ArshamFN/WaveShare-Jetson-ROS2-Rover/README.md

# Autonomous Rover - Jetson + ROS2 Navigation

A 4WD autonomous ground robot built on the Waveshare UGV02 platform with an NVIDIA Jetson Orin Nano Super, running ROS2 Humble with live SLAM, Nav2 autonomous navigation, and autonomous mapping with a custom frontier explorer.





## Project Overview

**Goal:** Build a production-ready autonomous navigation system from scratch to demonstrate ROS2 development skills.

**Why This Project:**
- Master ROS2 architecture (nodes, topics, services, actions)
- Implement SLAM-based mapping and localization
- Deploy autonomous waypoint navigation with Nav2
- Document real engineering problem-solving
- Build an AI-ready platform for future computer vision integration

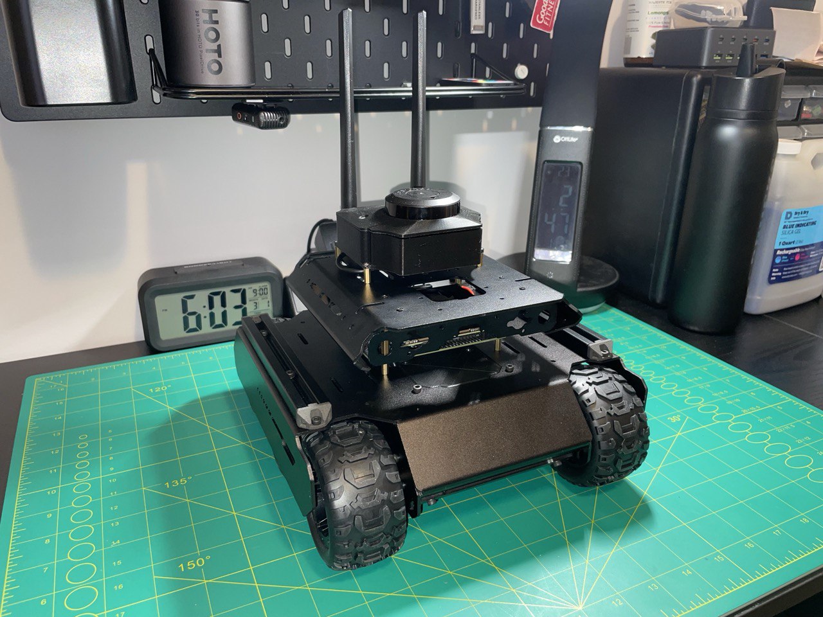
[picture p1: images/testing/session-006-migration/session-006-UGV02-front.jpg]
UGV02 fully assembled with migrated hardware


## Hardware Platform

### Core Components
- **Platform:** Waveshare UGV02 (4WD skid-steer chassis)
- **Compute:** NVIDIA Jetson Orin Nano Super Developer Kit (8GB RAM, 67 TOPS AI)
- **Sensors:** Slamtec RPLidar C1 (12m range, 10Hz, TOF technology)
- **Power:** 3× 18650 cells in series via WaveShare UPS Module 3S
- **Motor Control:** Multi-Functional Driver (MFD) board over USB serial (`/dev/rover`), running closed-loop wheel speed control

### Technical Specifications

| Component | Specification |
|---|---|
| **Drivetrain** | 4× DCGM-370-12V-EN-333RPM motors, skid-steer kinematics |
| **Encoder Resolution** | ~20 PPR (front wheels only; rear wheels unencoded) |
| **Motor Stall Torque** | ~5.0 kg·cm |
| **CPU** | 6-core ARM Cortex-A78AE @ 1.7GHz |
| **GPU** | 512 CUDA cores + Tensor cores (67 TOPS) |
| **RAM** | 8GB LPDDR5 |
| **LiDAR Range** | 12m max (white objects); 6m (black objects) |
| **LiDAR Scan Rate** | 5kHz sample rate @ 10Hz rotation |
| **LiDAR Angular Resolution** | 0.72° typical |
| **Light Resistance** | 40,000 lux |
| **Battery Pack** | 3S 18650, 11.1V nominal, 12.6V full charge |

### Power Architecture

| Component | Power Source |
|---|---|
| Jetson Orin Nano Super | BAT rail (9 to 12.6V) via 5.5mm barrel jack |
| MFD Board | BAT rail (9 to 12.6V) direct |
| RPLidar C1 | Jetson Orin Nano Super USB port |

### Runtime Estimates (25W Jetson mode, 25% real-world derating applied)

| Motor Load | Estimated Runtime |
|---|---|
| Cruising | ~47 min |
| Under load | ~35 min |

25W mode is the operational standard for SLAM sessions. It balances compute performance
with sufficient runtime for a full mapping run.

## Software Stack

- **Operating System:** Ubuntu 22.04 LTS (JetPack 6.2.1)
- **ROS Distribution:** ROS2 Humble Hawksbill
- **Navigation Framework:** Nav2 with the Regulated Pure Pursuit controller
- **Exploration:** `rover_explorer`, a custom frontier explorer; m-explore-ros2's `explore_lite` is kept as a baseline
- **SLAM Algorithm:** slam_toolbox (synchronous mapping mode, CeresSolver)
- **Odometry:** rf2o_laser_odometry (Range Flow-based 2D Odometry from laser scans)
- **Visualization:** RViz2
- **Remote Operation:** Foxglove desktop on a handheld ASUS ROG Ally, through `foxglove_bridge`
- **Development Languages:** Python 3.10, C++17

## Current Status

**Last Updated:** October 13, 2026

The rover navigates autonomously. Nav2 plans and follows paths on a map that
slam_toolbox builds live, and the rover drives to goal poses set in RViz, including
through narrow gaps. Pose estimation comes from the LiDAR: `rf2o_laser_odometry`
computes planar odometry from consecutive laser scans and owns the `odom → base_link`
transform. It replaced gyrodometry as the primary odometry source because gyroscope
calibration depends on both driving surface and operating temperature, while the LiDAR
is unaffected by either.

The `rover_driver` node converts velocity commands into wheel speed targets in m/s for
the MFD board's closed-loop speed controller, and lifts small non-zero commands to a
0.10 m/s floor that the controller can regulate. It also applies a velocity ramp, a
command watchdog, and Zero Velocity Update (ZUPT), and publishes wheel odometry on
`/odom_wheel`, raw gyroscope data on `/imu/gz`, and battery voltage on
`/battery_voltage`. Its heading hold controller is implemented but disabled, because
Nav2 runs its own closed loop.

The rover is operated from a handheld pendant: Foxglove desktop on an ASUS ROG Ally,
connected to `foxglove_bridge` on the Jetson. It shows the live map, laser scan, robot
pose, costmaps, and Nav2's planned path; sends Nav2 goals; drives the rover with the
Ally's sticks behind a deadman button; starts and stops the stack; saves maps; and shuts
the Jetson down. The Jetson joins home Wi-Fi when it is in range and otherwise hosts its
own network, so the pendant needs no router.

The rover also maps the house on its own. Once exploration is started, `rover_explorer`
chooses where to go next from the live map and sends Nav2 goals until no reachable
frontier is left, finishing one area before moving to the next. The autosave node then
drives the rover back to its start pose and saves the final map into `maps/`, keeping
map checkpoints, slam_toolbox pose graphs, and an event and battery log for every run.
`rover_explorer` replaced `explore_lite` after an offline simulator, run on real maps of
the house with the explorer's own planning code, showed it driving 19 to 28% less from
the same start poses.

The handheld control unit driving the rover while Nav2 navigates the house (https://www.youtube.com/watch?v=RMOsRye9tLc)

*[Watch on YouTube](https://www.youtube.com/watch?v=RMOsRye9tLc): the handheld control unit driving the rover while Nav2 navigates the house.*

### Completed Milestones

**Hardware:**
- ✅ Full mechanical assembly with custom 3D-printed MFD cover and RPLidar mount
- ✅ Power architecture designed and validated, with both boards on the BAT rail
- ✅ Persistent USB device symlinks: `/dev/lidar` (RPLidar C1), `/dev/rover` (MFD board)
- ✅ Platform migration from Wave Rover to UGV02 (motivated by encoder availability)

**Software:**
- ✅ JetPack 6.2.1 flashed and configured
- ✅ ROS2 Humble installed and verified
- ✅ Remote access via PuTTY (SSH) and NoMachine (desktop)
- ✅ RPLidar C1 driver built from source, with a live `/scan` topic confirmed
- ✅ `rover_driver` ROS2 node: full `/cmd_vel` to MFD JSON bridge operational
- ✅ `robot_description` package: URDF with a measured `base_link → laser` transform (0.1685 m height, 180° yaw)
- ✅ SLAM Toolbox configured in synchronous mapping mode with CeresSolver
- ✅ Gyrodometry implemented: gyroscope (`gz`) for heading, encoder average `(odl + odr) / 2` for linear displacement
- ✅ First coherent SLAM map produced with gyrodometry active
- ✅ Software velocity ramp on both axes: linear (0.8 m/s²) and angular (2.0 rad/s²)
- ✅ Forward-only heading hold PD controller: gyro-based straight-line correction with settle gate, deadband, spike clamp, and output cap
- ✅ Zero Velocity Update (ZUPT): continuous gyro bias correction during stationary pauses
- ✅ SLAM Toolbox parameters tuned: 1 s map updates, full 10 Hz scan ingestion, and a 15 m loop closure search radius
- ✅ `rf2o_laser_odometry` built from source and integrated, publishing `/odom` at 10 Hz
- ✅ Odometry architecture migrated to LiDAR-primary: RF2O owns `odom → base_link`, and wheel odometry is retained on `/odom_wheel` for comparison
- ✅ First geometrically accurate room map, with single-cell walls and every room feature correctly placed
- ✅ LiDAR orientation corrected in the URDF: the RPLidar C1's zero-bearing beam faces the rear of the rover
- ✅ Motor constants measured: `MAX_WHEEL_SPEED = 0.956 m/s` (LiDAR wall ranging), `TRACK_WIDTH = 0.174 m` (caliper), acceleration 0.648 m/s², deceleration 0.699 m/s²
- ✅ Nav2 integrated with Regulated Pure Pursuit: autonomous navigation to goal poses, including through narrow gaps
- ✅ `/cmd_vel` watchdog: the driver zeroes the wheel command if commands stop arriving for 0.5 s; the check runs on each feedback packet from the MFD board, so it depends on that feedback
- ✅ Battery monitoring on `/battery_voltage`, with warnings at 10.5 V and 9.6 V
- ✅ RF2O startup race fixed: the laser pose lookup now retries until the transform exists (patched fork)
- ✅ Wheel commands sent in m/s to the MFD's closed-loop speed controller, with a 0.10 m/s floor that makes low-speed motion and in-place rotation reliable on every surface tested
- ✅ Repository builds from a fresh clone, with third-party packages pinned in `rover.repos`
- ✅ Desktop launchers for bringup, teleop, and Nav2
- ✅ Handheld pendant: Foxglove desktop on an ASUS ROG Ally, connected to the Jetson through `foxglove_bridge`
- ✅ `twist_mux` velocity chain: stick teleop with a deadman overrides Nav2, with teleop-mode and e-stop locks
- ✅ systemd services for the bridge, pendant control, bringup, and Nav2, with a zero wheel command after every bringup stop
- ✅ Pendant control node: one-button start and stop, map saving by name, and a two-press safe shutdown
- ✅ Router-free operation: the Jetson hosts its own Wi-Fi network when home Wi-Fi is out of range
- ✅ ROS 2 discovery restricted to localhost, so a Wi-Fi change cannot split the ROS graph
- ✅ tf2 deadlock that froze Nav2 fixed by upgrading geometry2 to 0.25.24
- ✅ Autonomous mapping: `rover_explorer` explores the whole house without an operator and stops when no reachable frontier is left
- ✅ Frontier planner based on driving distance, reachability for the rover's footprint, viewpoints that see the frontier, commitment to the current target, and a route through the frontiers
- ✅ Map autosave: checkpoints every 5 minutes, return to the start pose, then the final map save, with per-run event, battery, and Nav2 logs
- ✅ Offline exploration simulator on real maps of the house, running the robot's own planner code
- ✅ systemd service for exploration that runs only while bringup and Nav2 are running

### Known Hardware Notes

- **MFD encoder wiring swap:** The `odl`/`odr` odometry fields in the MFD's T:1001 feedback
  packet are physically reversed, so left and right encoder readings are swapped on the
  board. All odometry code accounts for this swap.
- **Front-wheel-only encoding:** Only the front axle motors carry encoders. Rear wheels are
  passive and unencoded. Odometry is computed from front wheel data only.
- **Speed control floor:** The MFD's closed-loop wheel speed control cannot regulate
  targets below about 0.08 m/s, the limit of its 20 PPR encoders. `rover_driver` lifts
  any non-zero command below that to 0.10 m/s.
- **Skid-steer scrub:** In-place rotation achieves about 43% of the rate predicted from
  wheel speeds, consistently across surfaces, which corresponds to an effective track
  width of about 0.405 m. Nav2's closed loop absorbs the difference.
- **LiDAR zero bearing faces rearward:** With the RPLidar C1 mounted as documented, its
  zero-bearing beam points to the rear of the rover. The URDF laser joint carries a 180°
  yaw to match.
- **Battery sag under hard acceleration:** Commanding all four motors from a standstill at
  full speed causes a simultaneous peak current draw that can sag the battery below the
  Jetson's minimum operating voltage, triggering a protective shutdown. A software velocity
  ramp in `rover_driver` limits acceleration to 0.8 m/s² and eliminates the shutdown under
  normal operation.
- **ttyTHS1 UART bug:** The Jetson Orin Nano has a known data corruption bug on `/dev/ttyTHS1`
  requiring RTS/CTS hardware flow control. See the Session 002 log for the full fix.
  Rover communication uses the MFD's dedicated USB serial port (`/dev/rover`) for reliability.
- **UPS power rail routing:** The Jetson must be powered from the BAT rail via barrel jack,
  not the 5V regulated output. The 5V buck converter cannot handle the combined load of
  the MFD board and Jetson simultaneously.

## Getting Started

### Requirements

- Jetson running Ubuntu 22.04 (JetPack 6.2.1) with ROS2 Humble
- The ROS packages and tools the stack uses:

```bash
sudo apt install ros-humble-slam-toolbox ros-humble-navigation2 ros-humble-nav2-bringup \
  ros-humble-teleop-twist-keyboard python3-vcstool python3-serial \
  ros-humble-foxglove-bridge ros-humble-twist-mux ros-humble-teleop-twist-joy iw \
  python3-scipy
```

- tf2 (geometry2) 0.25.24 or newer: 0.25.23 can deadlock Nav2 inside tf2's `Buffer`
  (see the Session 016 log)

- The `/dev/rover` udev symlink for the MFD board (see [`src/rover_driver/README.md`](src/rover_driver/README.md))

### Build

The repository is a complete colcon workspace. The launchers and the Nav2 command below
assume it lives at `~/ros2_ws`.

```bash
git clone https://github.com/ArshamFN/WaveShare-Jetson-ROS2-Rover.git ~/ros2_ws
cd ~/ros2_ws
vcs import src < rover.repos
source /opt/ros/humble/setup.bash
colcon build --symlink-install
source install/setup.bash
```

`vcs import` pulls the three third-party packages at the exact commits pinned in
`rover.repos`: a patched fork of `rf2o_laser_odometry`, Slamtec's `rplidar_ros`, and
m-explore-ros2, whose `explore_lite` is kept as an exploration baseline.

All ROS 2 nodes run on the Jetson, so ROS 2 discovery is restricted to localhost, which
keeps a Wi-Fi change from splitting the ROS graph. The services and desktop launchers set
this themselves; for terminals, add it to `~/.bashrc` after the ROS setup lines:

```bash
echo 'export ROS_LOCALHOST_ONLY=1' >> ~/.bashrc
```

ROS 2 tools, including RViz, run on the Jetson itself, for example through NoMachine.

### Run

Bring up the driver, velocity mux, joystick teleop, LiDAR, RF2O, and slam_toolbox in one command:

```bash
ros2 launch robot_description bringup.launch.py
```

Add `use_rviz:=true` to open RViz on the Jetson. Then, in separate terminals, drive
with the keyboard:

```bash
ros2 run teleop_twist_keyboard teleop_twist_keyboard
```

or start Nav2 and send goals from RViz with the Nav2 Goal tool (Fixed Frame `map`):

```bash
ros2 launch nav2_bringup navigation_launch.py use_sim_time:=false \
  params_file:=$HOME/ros2_ws/src/robot_description/config/nav2_params.yaml
```

`teleop_twist_keyboard` publishes on `/cmd_vel`, which `twist_mux` in bringup treats as
the navigation input, so either pendant lock blocks it. With the services from
[Handheld Pendant](#handheld-pendant) installed, the pendant can also start and stop
bringup and Nav2. Start them from one place at a time: the pendant refuses to start
either while a copy started elsewhere is running.

### Autonomous Exploration

With bringup, Nav2, and the pendant control node running (the autosave node saves maps
through `/pendant/save_map`), start exploration through its service:

```bash
systemctl --user start rover-explore
journalctl --user -u rover-explore -f -o cat
```

or directly:

```bash
ros2 launch rover_explore explore.launch.py
```

Add `explorer:=explore_lite` to run the baseline instead. The rover explores until no
reachable frontier is left, drives back to its start pose, and saves the final map as
`maps/explore_<YYYYMMDD-HHMMSS>_final.pgm` and `.yaml`. Checkpoints, pose graphs, and
the run's `events.csv` and `battery.csv` go to `~/rover_runs/explore_<YYYYMMDD-HHMMSS>/`.
`systemctl --user stop rover-explore` pauses exploration, which cancels the current goal
or the drive home, and then stops both nodes. A run stopped before exploration completes
keeps its checkpoints and the live SLAM map, but saves no final map.

### Desktop Launchers

`tools/launchers/` holds one-click desktop launchers for bringup, teleop, and Nav2. To
install them:

```bash
mkdir -p ~/bin
for s in bringup_rover teleop_rover nav2_rover; do ln -sf ~/ros2_ws/tools/launchers/$s.sh ~/bin/$s.sh; done
cp ~/ros2_ws/tools/launchers/*.desktop ~/Desktop/
for d in ~/Desktop/Rover*.desktop; do chmod +x "$d"; gio set "$d" metadata::trusted true; done
```

The `.desktop` files point at `/home/arshamfn/bin`; adjust their `Exec` lines for a
different user.

### Handheld Pendant

The pendant is Foxglove desktop on an ASUS ROG Ally running Windows 11; nothing
ROS-related runs on the Ally. Foxglove connects to `foxglove_bridge` over a WebSocket on
port 8765, at the Jetson's address on the home network or at `ws://10.42.0.1:8765` on
the rover's own network. The layout shows the live map, laser scan, robot pose,
costmaps, and Nav2's planned path; sends Nav2 goals; drives the rover with the Ally's
sticks behind a deadman button; starts and stops the stack; saves maps; and shuts the
Jetson down.

**Velocity chain.** `twist_mux` merges the velocity sources into `/cmd_vel_mux`, the
only velocity input of `rover_driver`. Nav2 is unchanged.

| Input or lock | Topic | Priority | Timeout |
|---|---|---|---|
| Navigation (Nav2, keyboard teleop) | `/cmd_vel` | 10 | 0.5 s |
| Joystick | `/cmd_vel_joy` | 100 | 0.5 s |
| Teleop-mode lock | `/pendant/teleop_mode` (`std_msgs/Bool`) | 50 | none |
| E-stop lock | `/pendant/estop` (`std_msgs/Bool`) | 255 | none |

While LB (button 4) is held, `teleop_twist_joy` turns the pendant's `/joy` into
`/cmd_vel_joy`, up to 0.25 m/s and 1.5 rad/s. Releasing LB stops the rover, and Nav2
resumes once the joystick input times out. The locks do not time out and the e-stop lock
travels over Wi-Fi, so the chassis power switch remains the emergency stop.

**Services.**

| Service | Starts | Runs |
|---|---|---|
| `rover-bridge` | at boot | `foxglove_bridge` |
| `rover-control` | at boot | the `pendant_bridge` control node |
| `rover-bringup` | on demand | `bringup.launch.py` without RViz, then `rover_zero_motors.py` after every stop or crash, because the MFD board keeps executing its last command |
| `rover-nav2` | on demand | Nav2, stopping whenever bringup stops |
| `rover-explore` | on demand | `explore.launch.py`; refuses to start unless bringup and Nav2 are running, stops with either, and pauses exploration before it stops |

**Pendant interface.**

| Name | Type | Purpose |
|---|---|---|
| `/pendant/toggle_bringup` | `Trigger` | Starts bringup if stopped and stops it if running; refuses while it is starting or stopping, and presses less than 2 s apart |
| `/pendant/toggle_nav2` | `Trigger` | The same for Nav2; starts it only while bringup runs |
| `/pendant/set_bringup`, `/pendant/set_nav2` | `SetBool` | Explicit start and stop |
| `/pendant/save_map` | `SaveMap` | Saves `maps/<name>.pgm` and `.yaml`; letters, digits, `_` and `-` only; never overwrites |
| `/pendant/shutdown` | `Trigger` | Two presses within 5 s stop Nav2, then bringup, then power the Jetson off |
| `/pendant/bringup_active`, `/pendant/nav2_active` | `Bool` | State, 1 Hz |
| `/pendant/control_result` | `String` | One line per command outcome |

**Network.** The onboard Wi-Fi card cannot host a network and join one at the same time.
At boot the Jetson joins home Wi-Fi if it is in range; otherwise NetworkManager starts
the rover's own network, `NullIsland-Rover` (2.4 GHz, channel 6, WPA2, Jetson at
`10.42.0.1`). While running, the `rover-net-watchdog` system service checks every 15 s:
with no Wi-Fi connection for 60 s it starts the rover's network; while a client is
connected to the rover's network it takes no action; after 5 minutes with no client it
tries home Wi-Fi for up to 40 s and restores the rover's network if home Wi-Fi is not
there. A reading that fails or hangs never causes a change.

**Setup on the Jetson:**

1. User services, with lingering so they start at boot without a login:

   ```bash
   cd ~/ros2_ws && ./tools/systemd/install.sh
   sudo loginctl enable-linger "$(whoami)"
   ```

2. Permission for the pendant to power off the Jetson, validated before it is
   installed:

   ```bash
   echo "$(whoami) ALL=(root) NOPASSWD: /usr/bin/systemctl poweroff" > ~/rover-poweroff.sudoers
   sudo visudo -cf ~/rover-poweroff.sudoers
   sudo install -m 0440 -o root -g root ~/rover-poweroff.sudoers /etc/sudoers.d/rover-poweroff
   rm ~/rover-poweroff.sudoers
   ```

3. The rover's network, with the password typed rather than saved in shell history, and
   the home network ranked above it:

   ```bash
   nmcli con add type wifi ifname wlP1p1s0 con-name rover-ap ssid NullIsland-Rover \
     802-11-wireless.mode ap 802-11-wireless.band bg 802-11-wireless.channel 6 \
     ipv4.method shared ipv4.addresses 10.42.0.1/24 ipv6.method disabled \
     wifi-sec.key-mgmt wpa-psk wifi-sec.proto rsn wifi-sec.pairwise ccmp wifi-sec.group ccmp \
     connection.autoconnect no connection.autoconnect-priority -100
   read -rs P && nmcli con modify rover-ap wifi-sec.psk "$P" && unset P
   nmcli con modify rover-ap connection.autoconnect yes
   nmcli con modify "<home network>" connection.autoconnect-priority 10
   ```

4. The network watchdog. Its settings file holds the home Wi-Fi's name, so it lives
   outside the repository, in `/etc/rover-net-watchdog.conf`. The first command installs
   the template only if that file does not exist yet; in the editor, replace
   `[Home Wi-Fi name here]` with the NetworkManager name of the home Wi-Fi
   (`nmcli -t -f NAME,TYPE connection show` lists them):

   ```bash
   [ -e /etc/rover-net-watchdog.conf ] || sudo install -m 0600 -o root -g root tools/network/rover-net-watchdog.conf /etc/rover-net-watchdog.conf
   sudoedit /etc/rover-net-watchdog.conf
   sudo install -m 0755 -o root -g root tools/network/rover-net-watchdog.sh /usr/local/sbin/rover-net-watchdog
   sudo install -m 0644 -o root -g root tools/network/rover-net-watchdog.service /etc/systemd/system/rover-net-watchdog.service
   sudo systemctl daemon-reload
   sudo systemctl enable rover-net-watchdog
   sudo systemctl restart rover-net-watchdog
   ```

   If the settings file is missing or still holds the placeholder, the watchdog logs the
   reason and exits without changing the network. NetworkManager's boot fallback works
   without it.

5. The `ROS_LOCALHOST_ONLY` line from [Build](#build).

**Setup on the Ally.** Install Foxglove desktop and sign in once while online; it runs
offline afterwards. Install the Joystick panel extension (`joshnewans/foxglove-joystick`)
and set the Ally's control mode to Gamepad. The layout uses:

- a 3D panel with display frame `map` showing `/map`, `/scan`, the costmaps and `/plan`,
  with its pose publish tool on `/goal_pose`;
- a Joystick panel in Gamepad mode with Publish Mode on, publishing `/joy`;
- Service Call panels for `/pendant/toggle_bringup`, `/pendant/toggle_nav2` and
  `/pendant/shutdown` (request `{}`) and for `/pendant/save_map` (request
  `{"name": {"data": "<name>"}}`);
- Indicator panels on `/pendant/bringup_active.data` and `/pendant/nav2_active.data`;
- a gauge on `/battery_voltage.data`;
- a Raw Message panel on `/pendant/control_result.data`.

### Repository Layout

```
.gitignore  LICENSE  README.md  rover.repos
cad/                       CAD files for the custom covers and mounts
docs/                      bill of materials, software notes, and session logs
images/                    build and test photos
maps/                      saved slam_toolbox maps
scripts/                   calibration and test scripts
tools/launchers/           desktop launchers for bringup, teleop, and Nav2
tools/systemd/             systemd user services for the pendant, the stack, and exploration
tools/network/             network watchdog: home Wi-Fi or the rover's own network
tools/explore_sim/         offline exploration simulator
src/rover_driver/          /cmd_vel to MFD bridge
src/robot_description/     URDF, launch files, and parameters
src/pendant_bridge/        pendant control node
src/rover_explore/         frontier explorer and map autosave node
src/rf2o_laser_odometry/   not tracked; pulled via rover.repos
src/rplidar_ros/           not tracked; pulled via rover.repos
src/m-explore-ros2/        not tracked; pulled via rover.repos
```

## ROS2 Packages

### rover_driver
A ROS2 Python node that bridges the standard `/cmd_vel` topic to the UGV02 MFD board's
JSON-over-serial protocol. It converts each `geometry_msgs/Twist` into left and right
wheel speed targets in m/s, which the board's closed-loop controller holds. Non-zero
targets below the controller's regulation floor are scaled up together to 0.10 m/s,
preserving the commanded turn curvature. The node also applies a velocity ramp on both
axes, zeroes the wheel command if `/cmd_vel` goes stale for 0.5 s (checked on each
feedback packet from the board, so the check depends on that feedback), and runs ZUPT
for continuous gyro bias correction. It publishes wheel-derived odometry to
`/odom_wheel`, raw gyroscope data to `/imu/gz`, and battery voltage to
`/battery_voltage`. It does not
broadcast `odom → base_link`; that transform is owned by `rf2o_laser_odometry`. A
forward-only heading hold PD controller is implemented but disabled by default, because
Nav2 runs its own closed loop.

```bash
ros2 run rover_driver rover_driver_node
```

See [`src/rover_driver/README.md`](src/rover_driver/README.md) for full setup instructions.

### robot_description
A ROS2 package containing the rover's URDF, launch files, and parameters. The URDF
defines the `base_link → laser` transform at 0.1685 m height with a 180° yaw, derived
from physical measurement. `bringup.launch.py` starts `robot_state_publisher`,
`rover_driver`, `twist_mux`, `teleop_twist_joy`, the LiDAR driver, RF2O (after 3 s), and
slam_toolbox (after 5 s), with optional RViz. `rover_driver`'s velocity input is
remapped to `/cmd_vel_mux`. The `config/` directory holds the slam_toolbox, RF2O, and
Nav2 parameters, and the `twist_mux` and joystick teleop parameters. slam_toolbox is
tuned for 1 s map updates, full 10 Hz scan ingestion, and a 15 m loop closure search
radius suited to indoor mapping.

```bash
ros2 launch robot_description bringup.launch.py
```

### pendant_bridge
A ROS2 Python node, `pendant_control`, that lets the handheld pendant run the rover. It
starts and stops the bringup and Nav2 services through `systemctl --user`, publishes
their state, saves the live map with `nav2_map_server`'s `map_saver_cli`, and runs the
two-press shutdown. It refuses to start bringup or Nav2 while a copy started outside
systemd is running, and it powers the Jetson off only when its `allow_poweroff`
parameter is true, which only the installed service sets.

```bash
ros2 run pendant_bridge control_node
```

### rover_explore
Autonomous mapping: the `rover_explorer` frontier explorer, the `explore_autosave` node,
and `explore.launch.py`, which starts the autosave node and, 3 s later, the explorer.

`rover_explorer` keeps every exploration decision in `frontier_planner.py`, which uses
only numpy and scipy, so the offline simulator in `tools/explore_sim/` runs the same code.
Every 2 s, and after each Nav2 goal ends, it finds the frontiers between known free and
unknown space on `/map`, the cells the rover's footprint can reach, and for each frontier
a viewpoint that sees a useful part of it, preferring viewpoints with 0.25 m of
clearance. It ranks the frontiers by driving distance to their viewpoints plus a turn
cost, orders the 20 cheapest into a route by the driving distances between viewpoints,
keeps its current target unless the route is shorter without it, and sends one
`navigate_to_pose` goal at a time, re-sending it only when the viewpoint moves 0.5 m or
more. A frontier that teaches the map nothing is retried from a viewpoint at
least 1 m away and excluded after two such viewpoints, or after a repeated Nav2 failure.
Exploration is complete after two decisions in a row, each on a newer map, find no
reachable frontier. The node publishes the same `/explore/status` messages as
`explore_lite`, obeys `/explore/resume`, and draws the frontiers, its target, and
excluded frontiers on `/explore/frontiers`.

`explore_autosave` saves a map checkpoint every 5 minutes while exploration runs and
serializes the slam_toolbox pose graph with every save. When exploration completes it
drives the rover back to the pose it had at startup, then saves the final map into
`maps/`. It logs events and battery voltage to CSV files in the run folder, together with
Nav2's goal, failure, and recovery counts and the distance driven from `/odom`. It never
publishes velocity commands.

All parameters are in `config/explore_params.yaml`.

```bash
ros2 launch rover_explore explore.launch.py
```

### rf2o_laser_odometry
Range Flow-based 2D Odometry: estimates planar motion directly from consecutive
RPLidar scans and publishes `nav_msgs/Odometry` to `/odom` along with the
`odom → base_link` transform. Built from a fork of the Adlink-ROS ROS2 port, patched
so the node retries its `base_link → laser` lookup at startup instead of silently
falling back to an identity transform. Its parameters live in
`src/robot_description/config/rf2o_params.yaml`, including an empty
`init_pose_from_topic`: left at its default of `/base_pose_ground_truth`, a
simulation-only topic, the node waits indefinitely on real hardware.

See [`docs/software/rf2o-laser-odometry.md`](docs/software/rf2o-laser-odometry.md) for build notes.

### rplidar_ros
Slamtec's official ROS2 LiDAR driver, built from source to include RPLidar C1 support.

```bash
ros2 launch rplidar_ros rplidar_c1_launch.py
```

See [`docs/software/rplidar-ros.md`](docs/software/rplidar-ros.md) for full setup instructions.

## Documentation

- [Bill of Materials](docs/hardware/bill-of-materials.md): complete parts list with suppliers and costs
- [Test Logs & Build Journal](docs/testing/0000-test-logs.md): full session-by-session build history
- [RF2O Laser Odometry notes](docs/software/rf2o-laser-odometry.md)
- [RPLidar ROS2 driver notes](docs/software/rplidar-ros.md)
- [Exploration simulator](tools/explore_sim/README.md)

## Author

**Arsham Faghihnasiri**

Building autonomous systems and learning production ROS2 development.

- 📍 Greater Toronto Area, Ontario, Canada
- 💼 [LinkedIn](https://www.linkedin.com/in/arsham-faghihnasiri)
- 📧 arshamfaghihnasiri@gmail.com
- 🎓 Software Engineering

## Acknowledgments

- Waveshare for the UGV02 platform and MFD board
- NVIDIA for Jetson developer tools and documentation
- Slamtec for the RPLidar SDK and ROS2 driver
- MAPIRlab for rf2o_laser_odometry, and Adlink-ROS for its ROS2 port
- Jiří Hörner for explore_lite, and robo-friends for its ROS2 port, m-explore-ros2
- The ROS2 and Nav2 open source communities

## License

MIT License. See [LICENSE](LICENSE) for details.
