ArshamFN/WaveShare-Jetson-ROS2-Rover/cad/rover-top-face-reference/WaveShare-Wave-Rover-Top-Face-Reference-README.md

# Rover Top Face Reference
   3D model of the rover's top face, used as a reference for designing the Jetson mount.
