ArshamFN/WaveShare-Jetson-ROS2-Rover/cad/rover-top-face-reference/WaveShare-Wave-Rover-Top-Face-Reference.png

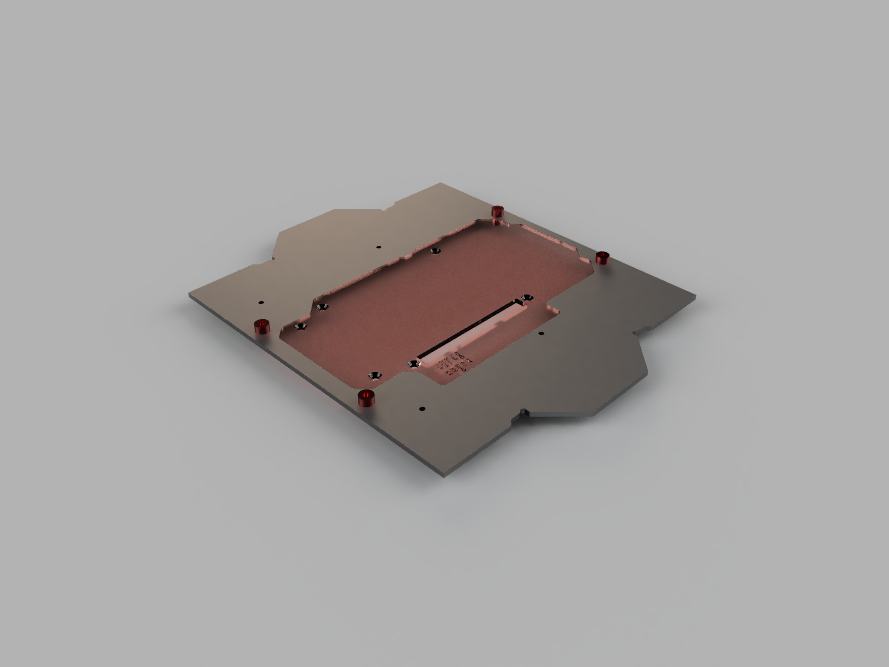
cad/rover-top-face-reference/WaveShare-Wave-Rover-Top-Face-Reference.png
