ArshamFN/WaveShare-Jetson-ROS2-Rover/docs/hardware/bill-of-materials.md

# Bill of Materials

**Last Updated:** Feb 22, 2026
**Total Cost:** ~$807 CAD (after tax)

---

## Core Platform

| Item | Model | Qty | Unit Price | Total | Supplier | Status |
|---|---|-----|---|---|---|---|
| Robot Base | Waveshare Wave Rover | 1 | $136.55 | $136.55 | Amazon.ca | ✅ Received |
| Compute Board | NVIDIA Jetson Orin Nano Super Developer Kit (8GB) | 1 | $375.67 | $375.67 | Amazon.ca | ✅ Received |
| Lidar Sensor | Slamtec RPLidar C1 | 1 | $93.99 | $93.99 | Amazon.ca | ✅ Received |
| Batteries | 18650 Lithium (2200mAh+) | 4 | - | $65.98 | Amazon.ca | ✅ Received |

**Subtotal:** $672.19 CAD (before tax)
**Subtotal with tax:** $759.58 CAD

---

## Additional Hardware

| Item | Qty | Price (after tax) | Supplier | Status |
|---|-----|---|---|---|
| DisplayPort to HDMI Cable (6ft) | 1 | $12.42 | Amazon.ca | ✅ Received |
| M2.5 40+6mm Female-to-Male Brass Hex Standoff Spacers (20pcs) | 1 | $19.20 | Amazon.ca | ✅ Received |
| Dual Band WiFi Antenna Kit + MHF4 IPEX Pigtail Cables (M.2/NGFF, 2x5dBi) | 1 | $15.22 | Amazon.ca | ✅ Received |

**Subtotal:** $46.84 CAD (after tax)

---

## Accessories (Included with Wave Rover)

- ESP32 controller module
- UPS power management board
- 4x N20 motors with encoders
- 4x Wheels
- Metal chassis with mounting plates
- Servo expansion board

---

## TOTAL PROJECT COST: ~$806 CAD (after tax)

---

## Notes

- Batteries: 4x purchased, 3x used for rover (1x spare)
- Standoffs used for mounting Jetson Orin Nano Super to rover
- WiFi antenna required for reliable wireless connectivity on Jetson
- All core components confirmed compatible with ROS2 Humble
- Power system rated for ~2-3 hours runtime
```
