ArshamFN/WaveShare-Jetson-ROS2-Rover/cad/rover-top-face-reference/WaveShare-Wave-Rover-Top-Face-Reference.step

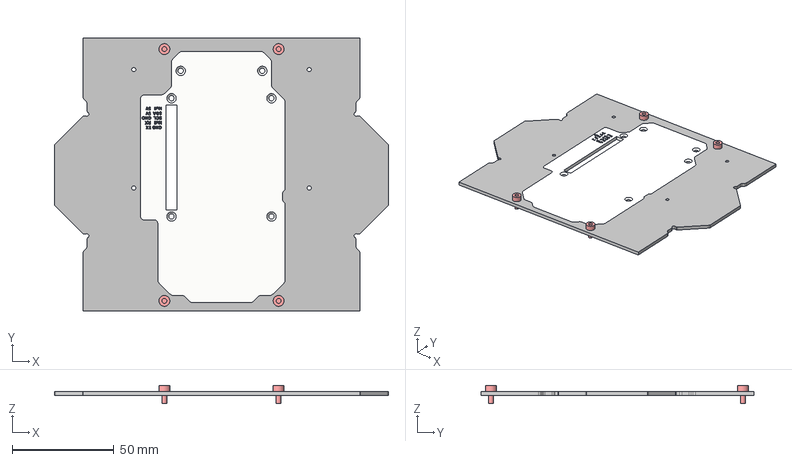
[picture p7: CAD file, 2026-02-22]
cad/rover-top-face-reference/WaveShare-Wave-Rover-Top-Face-Reference.step
163.7 x 133.7 x 8.92 mm
