ArshamFN/WaveShare-Jetson-ROS2-Rover/cad/Rover-Top-Cover/v1/Rover-Top-Cover-v1.stl

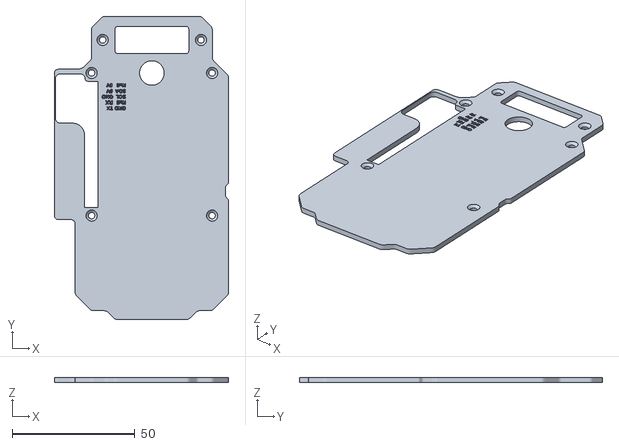
[picture p8: CAD file, 2026-02-27, an earlier design]
cad/Rover-Top-Cover/v1/Rover-Top-Cover-v1.stl
70.9 x 123.2 x 2.00
