ArshamFN/WaveShare-Jetson-ROS2-Rover/(list of files, cad)

Other CAD files:
cad/rover-top-face-reference/WaveShare-Wave-Rover-Top-Face-Reference.f3d
