ArshamFN/WaveShare-Jetson-ROS2-Rover/images/build/final-assembly/session-004-full-assembly-with-lidar.jpg.jpg

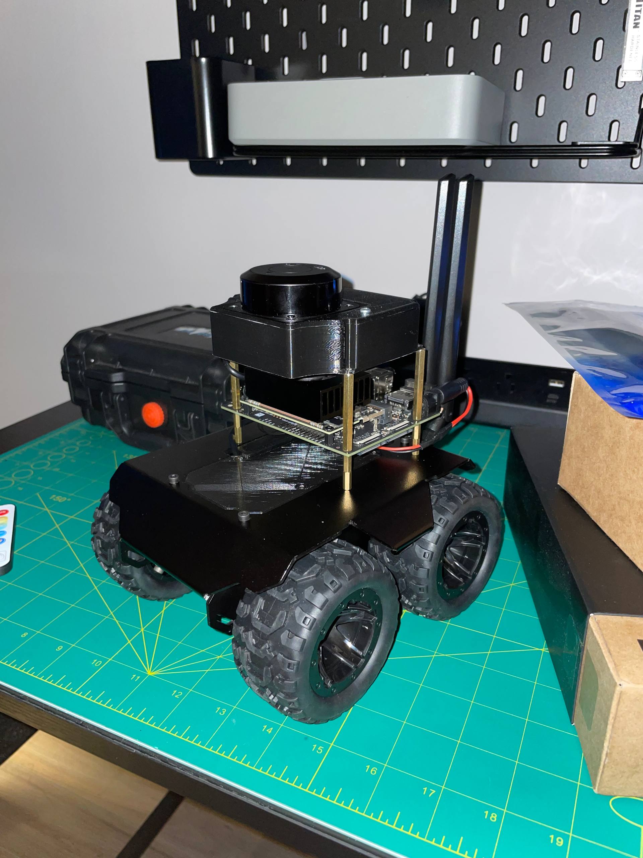
images/build/final-assembly/session-004-full-assembly-with-lidar.jpg.jpg
