ArshamFN/WaveShare-Jetson-ROS2-Rover/images/build/WaveShare-Wave-Rover-Dimensions.jpg

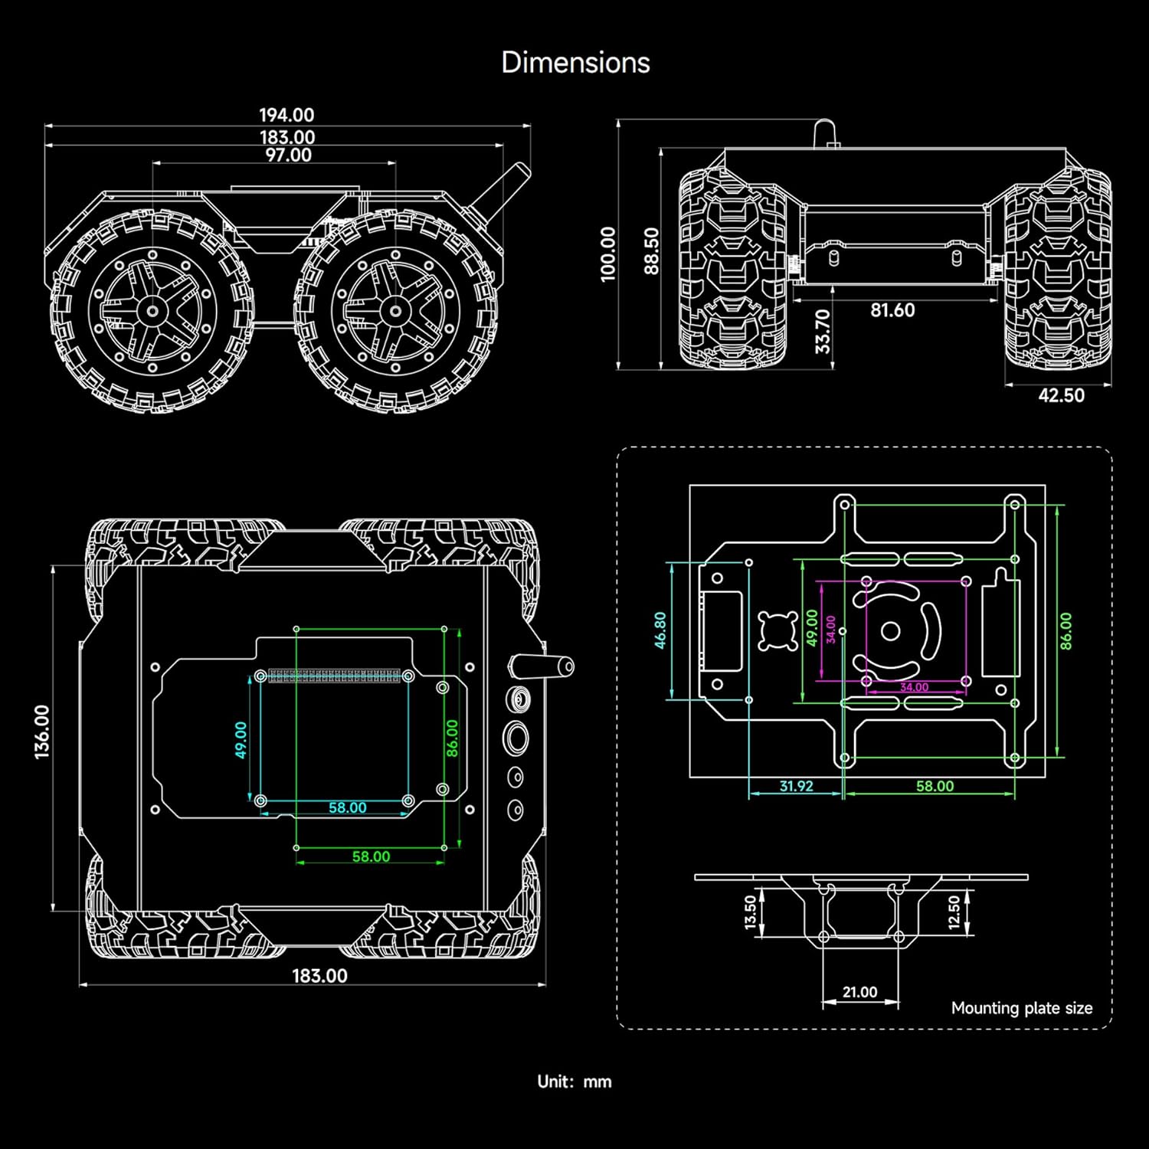
images/build/WaveShare-Wave-Rover-Dimensions.jpg
