ArshamFN/WaveShare-Jetson-ROS2-Rover/docs/testing/0000-test-logs.md

# Test Logs & Build Journal

## Purpose
This file serves as an index of all session logs. Each session has its own
dedicated file in this folder with full details.

---

## Session Index

| Session | Date | Title | Status |
|---|---|---|---|
| 000 | 2026-02-16 | Project Kickoff & Parts Ordered | ✅ Complete |
| 001 | 2026-02-20 | Jetson Setup, Remote Access & UART Debugging | ✅ Complete |
| 002 | 2026-02-22 | UART Debugging & Breakthrough | ✅ Complete |
| 003 | 2026-02-23 | CAD Design: GRD Cover & RPLidar Mount | ✅ Complete |
| 004 | 2026-02-24 | Power Debugging, LiDAR Integration & ROS2 Motor Control | ✅ Complete |
| 005 | 2026-02-27 | URDF, tf2, and First SLAM Map | ✅ Complete |
| 006 | 2026-02-28 | Hardware Assessment & Platform Migration: Wave Rover → UGV02 | ✅ Complete |
| 007 | 2026-03-02 | First Teleoperated SLAM Run & Odometry Calibration | ✅ Complete |
| 008 | 2026-03-03 | Automated Calibration Script & Battery Sag Discovery | ✅ Complete |
| 009 | 2026-03-04 | Hybrid Odometry & First Proper SLAM Map | ✅ Complete |
| 010 | 2026-03-09 | Heading Hold, Velocity Ramp, ZUPT, PD Controller, and SLAM Tuning | ✅ Complete |
| 011 | 2026-03-13 | Universal Heading Hold Tune for Mixed Surfaces | ✅ Complete |
| 012 | 2026-08-18 | Switching to Lidar-Based Odometry | ✅ Complete |
| 013 | 2026-08-21 | Nav2 Integration and First Autonomous Navigation | ✅ Complete |
| 014 | 2026-09-24 | Stack Audit, RF2O Startup Race, and the Wheel-Speed Floor | ✅ Complete |
| 015 | 2026-09-25 | Handheld Control Unit on the ROG Ally Without a Router | ✅ Complete |
| 016 | 2026-10-06 | Autonomous Mapping With My Own Frontier Explorer | ✅ Complete |
| 017 | 2026-10-13 | How Each Node Works, and the Conclusion of Project #1 | ✅ Complete |

---

## Session 000 — 2026-02-16: Project Kickoff & Parts Ordered
**Goal:** Finalize platform choice, create GitHub repository, and order all components.

**Summary:** Platform research completed and all hardware decisions finalized.
Repository created and documentation structure set up. All components ordered
for ~$760 CAD total. No issues encountered.

BENKIA 18650 cells
Wave Rover box contents
Jetson Orin Nano box contents
RPLidar C1 unit and USB adapter

---

## Session 001 — 2026-02-20: Jetson Setup, Remote Access & UART Debugging
**Goal:** Set up the Jetson Orin Nano Super, establish remote access,
and achieve working UART communication with the Wave Rover.

**Summary:** Jetson successfully flashed, configured, and updated to JetPack 6.2.1.
Remote access established via PuTTY (SSH) and NoMachine (desktop). ROS2 Humble
installed successfully. Rover wired to Jetson — no existing documentation for this
hardware combination, so the process was pieced together from multiple sources.
UART communication established but all received data was garbled. Continued in Session 002.

Jetson first mounted on rover
Jetson first mounted on rover

**→ [Full session log](2026-02-20-session-001-jetson-setup-uart-debugging.md)**

---

## Session 002 — 2026-02-22: UART Debugging & Breakthrough
**Goal:** Identify root cause of garbled UART data and establish working
communication with the Wave Rover.

**Summary:** Two compounding hardware issues identified and resolved. First, the
Jetson Nano Adapter (C) was inserted upside down, holding the ESP32's boot pin
at the wrong voltage. Second, the Jetson Orin Nano has a known ttyTHS1 data
corruption bug that requires RTS/CTS hardware flow control. Fixed by enabling
uarta-cts/rts in jetson-io and adding a jumper between pins 11 and 36. UART
communication fully working — rover moves on command from the Jetson. ✅

Jetson Nano Adapter (C) wiring closeup
Jetson 11&36 connection

**→ [Full session log](2026-02-22-session-002-UART-breakthrough.md)**

---

## Session 003 — 2026-02-23: CAD Design: GRD Cover & RPLidar Mount

**Goal:** Finalize CAD designs for the custom GRD electronics cover and
RPLidar C1 mounting case while waiting for antenna and standoff spacers to arrive.

**Summary:** Both CAD designs completed in Fusion 360. The GRD cover is a
functional redesign of the rover's original plastic electronics bay cap, adding
openings for the 40-pin header, improved OLED visibility, and WiFi antenna cable
routing. The RPLidar C1 mount was designed from scratch to secure the sensor
to the rover. No physical assembly this session — parts still in transit.

Custom GRD cover v1 installed
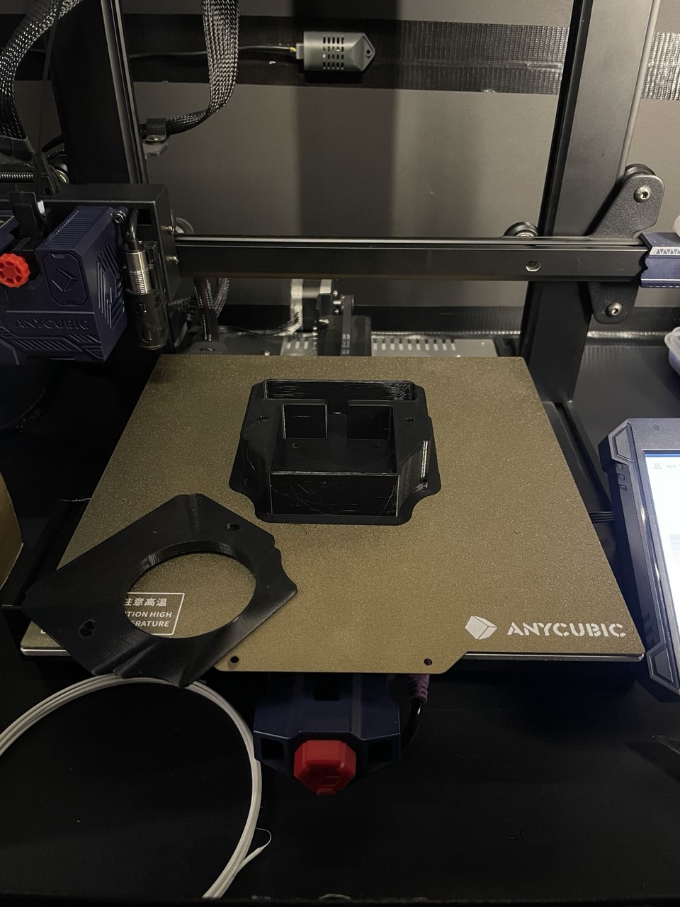
[picture p11: images/testing/session-003/session-003-lidar-mounting-case.jpg]
Custom lidar mounting case 3D-printed


**→ [Full session log](2026-02-23-session-003-cad-grd-cover-lidar-mount.md)**

---

## Session 004 — 2026-02-24: Power Debugging, LiDAR Integration & ROS2 Motor Control
**Goal:** Resolve power system fault from first full assembly boot, integrate the
RPLidar C1 into ROS2, and achieve complete rover motor control through the `/cmd_vel`
topic.
**Summary:** UPS power fault diagnosed and resolved — root cause was the Jetson's
Type-C standby draw overloading the 5V buck converter. Power architecture redesigned
to route both boards through the BAT rail, reserving the 5V output for peripherals.
Runtime analysis completed for the BENKIA 18650 pack across all Jetson power modes —
15W mode recommended for SLAM sessions (~56 min runtime). DisplayPort emulator ordered
to resolve headless NoMachine GPU issue. Persistent udev symlinks established for both
USB serial devices (`/dev/lidar`, `/dev/rover`). RPLidar C1 driver built from source
and confirmed publishing live `/scan` data. Rover communication switched to USB serial
for reliability. `rover_driver` ROS2 node written and deployed — full end-to-end motor
control via `/cmd_vel` confirmed. ✅

Rover with Jetson mounted, no LiDAR

**→ [Full session log](2026-02-24-session-004-power-architecture-LiDAR-integration-ROS2-motor-control.md)**

---

## Session 005 — 2026-02-27: URDF, tf2, and First SLAM Map
**Goal:** Create the `robot_description` ROS2 package, configure SLAM Toolbox,
and achieve a live occupancy grid map in RViz2.

**Summary:** Authored a Unified Robot Description Format (URDF) with accurate
real-world LiDAR transform measurements — 0.1685m z offset derived from physical
measurement, with zero x/y offsets by deliberate mechanical design. Verified the
tf2 transform tree with `tf2_tools view_frames`. Installed SLAM Toolbox and wrote
a full `slam_toolbox.yaml` configuration. Deployed a SLAM launch file with a
static `odom → base_link` placeholder for future wheel odometry. Full pipeline
confirmed: RPLidar C1 → `/scan` → SLAM Toolbox → `/map` → RViz2, with a live
occupancy grid map of the room visible. ✅

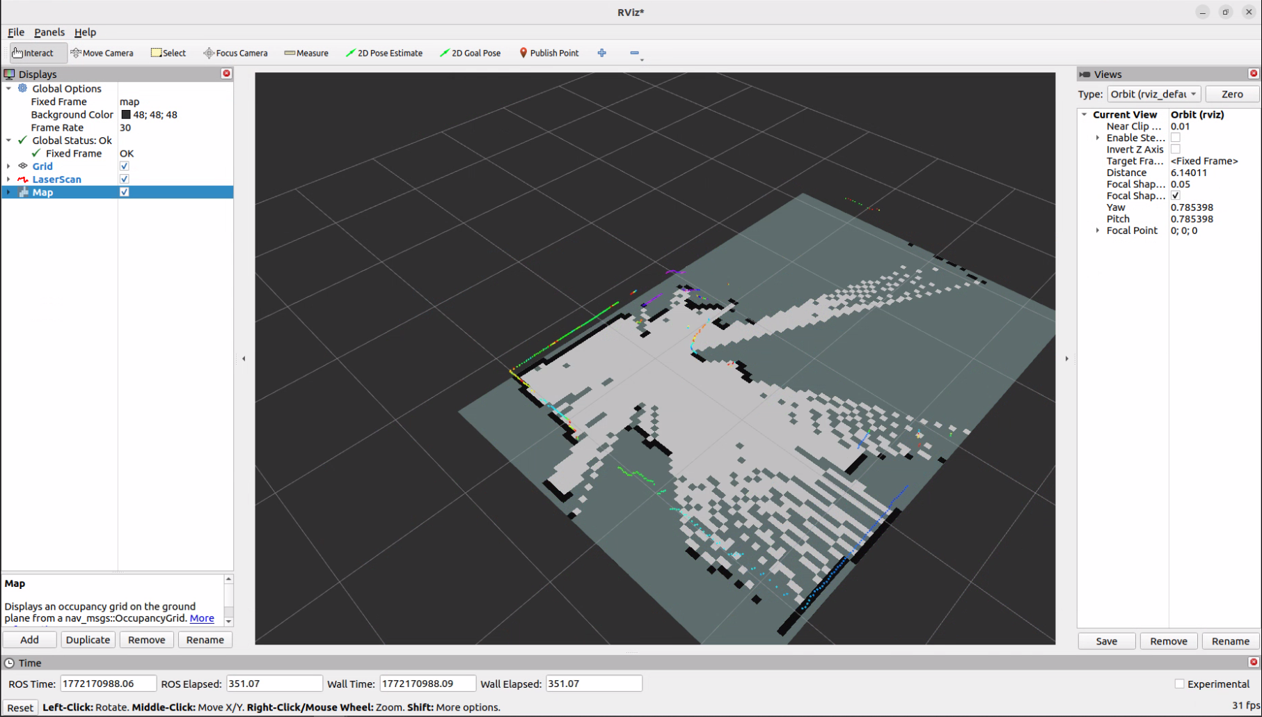
[picture p12: images/testing/session-005/session-005-first-slam-map.png]
First SLAM map — live occupancy grid in RViz2


**→ [Full session log](2026-02-27-session-005-URDF-tf2-and-first-SLAM-map.md)**

---

## Session 006 — 2026-02-28: Hardware Assessment & Platform Migration: Wave Rover → UGV02

**Goal:** Begin implementing encoder-based wheel odometry to replace the static
`odom → base_link` transform in `slam.launch.py`.

Wave Rover vs UGV02 side-by-side
*Left: UGV02 with DCGM-370 encoder motors.  Right: Wave Rover with N20 motors.*

**Summary:** Investigation into the GRD firmware revealed that the Wave Rover's N20 motors
have no encoders — the GRD encoder commands are only functional on the UGV01 product.
Simultaneously, the Wave Rover was chronically underpowered under the Jetson's payload,
struggling to move on carpet and stalling below full throttle. Three remediation paths were
evaluated: open-loop odometry integration (rejected — no meaningful improvement over the
static transform), partial motor swap to encoder-capable N20s (rejected — encoders on an
underpowered chassis produce unreliable ground truth), and full platform replacement
(selected). The Waveshare UGV02 was chosen after reviewing the official wiki, which
explicitly confirms encoder motors (`DCGM-370-12V-EN-333RPM`, encoder confirmed by EN
designation and visible hall-effect sensor connector) and a Multi-Functional Driver board
with native ROS continuous feedback mode. The UGV02 was received and the full hardware
migration was completed: Jetson, RPLidar C1, and the custom BAT-rail power wire from
Session 004 all transferred to the new chassis. Both 3D-printed parts — the RPLidar
mounting case and GRD top cover — fit the new chassis without modification. A video
documenting the technical reasoning and hardware transformation was recorded and edited.

UGV02 fully assembled with migrated hardware

**→ [Full session log](2026-02-28-session-006-hardware-assessment-platform-migration.md)**

---

## Session 007 — 2026-03-02: First Teleoperated SLAM Run & Odometry Calibration

**Goal:** Run the full SLAM stack for the first time with a teleoperated robot and
produce a geometrically accurate map of the room.

**Summary:** Linear scale factor successfully calibrated from 0.03125 to 0.01 via a
1-metre drive test (0.34% error). With correct linear scale, SLAM produced its first
coherent room outline. Rotational calibration proved much harder: physical ruler
measurement of wheel spacing (0.172m) was revealed to be the wrong approach —
`TRACK_WIDTH` refers to the kinematic turning diameter, not the physical wheel gap.
Six values were tested through L-shape map analysis with no reliable result. The root
problem is that every calibration method derived rotation from the same encoders being
calibrated, with no independent ground truth. Crab-walking from the wobbly middle
passive wheels further complicated all tests.

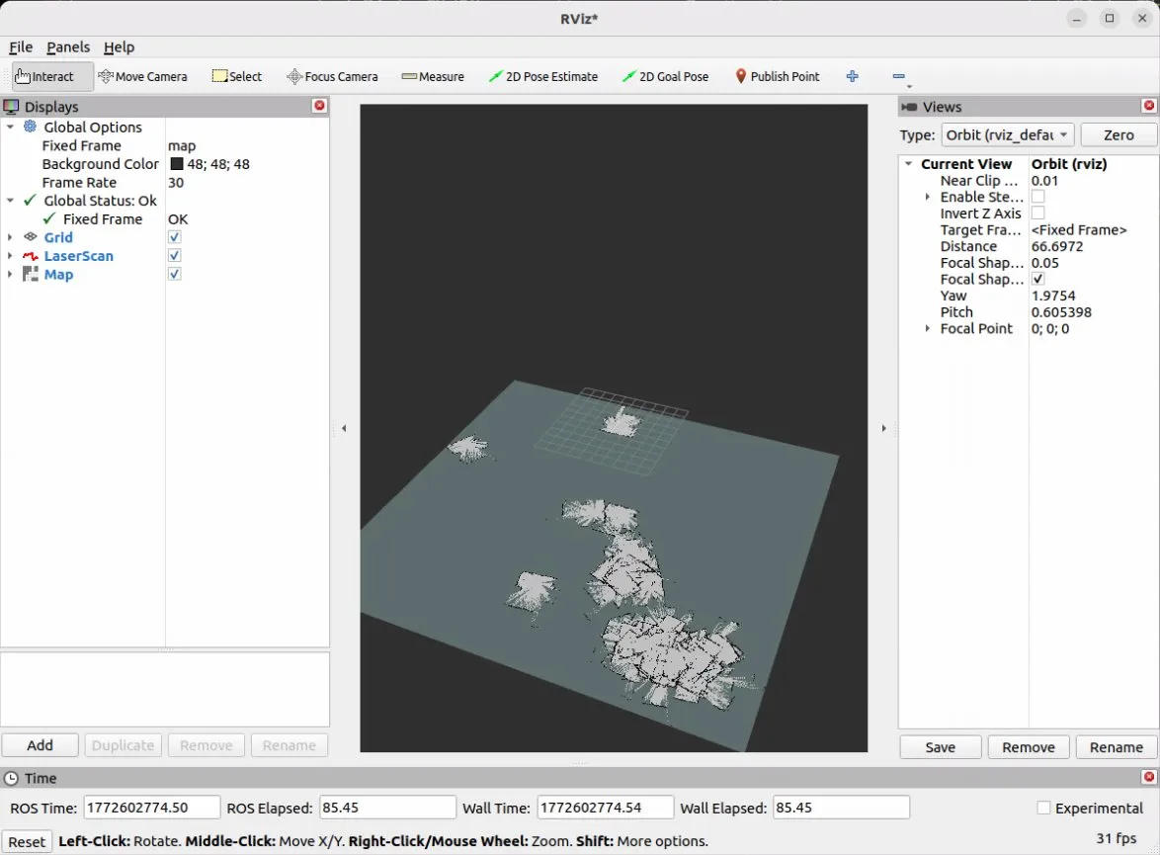
[picture p13: images/testing/session-007/session-007-TRACK_WIDTH-SLAM-issue.png]
TRACK_WIDTH SLAM issue


**→ [Full session log](2026-03-02-session-007-odometry-calibration.md)**

---

## Session 008 — 2026-03-03: Automated Calibration Script & Battery Sag Discovery
**Goal:** Determine `TRACK_WIDTH` through automated sensor-referenced calibration and
attempt teleop SLAM mapping with corrected odometry.

**Summary:** Wrote a 3-phase Python calibration script: accelerometer bias calibration at
rest, gyroscope scale calibration via manual 360° rotation, and an automated 90° CW motor
turn with simultaneous gyro and encoder recording to compute `TRACK_WIDTH` directly. The
script's raw output revealed that the MFD board's `odl`/`odr` labels are physically
reversed — the encoder swap was causing heading to be reported with the wrong sign on every
turn. After correcting the swap, `TRACK_WIDTH` was determined to be 0.0456 m. Subsequent
SLAM mapping attempt failed due to battery voltage sag causing asymmetric motor output and
unreliable encoder timing. This led to the architectural decision to use gyroscope-based
heading combined with encoder-based linear displacement (gyrodometry) for Session 009,
eliminating `TRACK_WIDTH` as a calibration parameter entirely.

**→ [Full session log](2026-03-03-session-008-calibration-script-encoder-swap.md)**

---

## Session 009 — 2026-03-04: Hybrid Odometry & First Proper SLAM Map

**Goal:** Implement a hybrid odometry node sourcing heading from the gyroscope and
linear displacement from the encoder average, removing `TRACK_WIDTH` from the
architecture entirely. Produce a reliable teleop SLAM map with the new node.

**Summary:** Wrote and deployed a new `rover_driver_node.py` implementing gyrodometry:
`gz` gyroscope integration for heading, encoder average `(odl + odr) / 2` for linear
displacement. `GZ_SCALE = 0.001058 rad/(count·s)` was obtained via the Phase 2 hand
rotation procedure from `calibrate_track_width.py` and validated by a 90° motor turn
measuring 90.04°. The result was the first geometrically correct SLAM map — clean
rectangular walls, sharp corners, no doubling. A stale `~/install/` directory from an
earlier session was also discovered to be shadowing `~/ros2_ws/install/`, causing the node
to run the wrong file after every rebuild; the directory was permanently deleted.

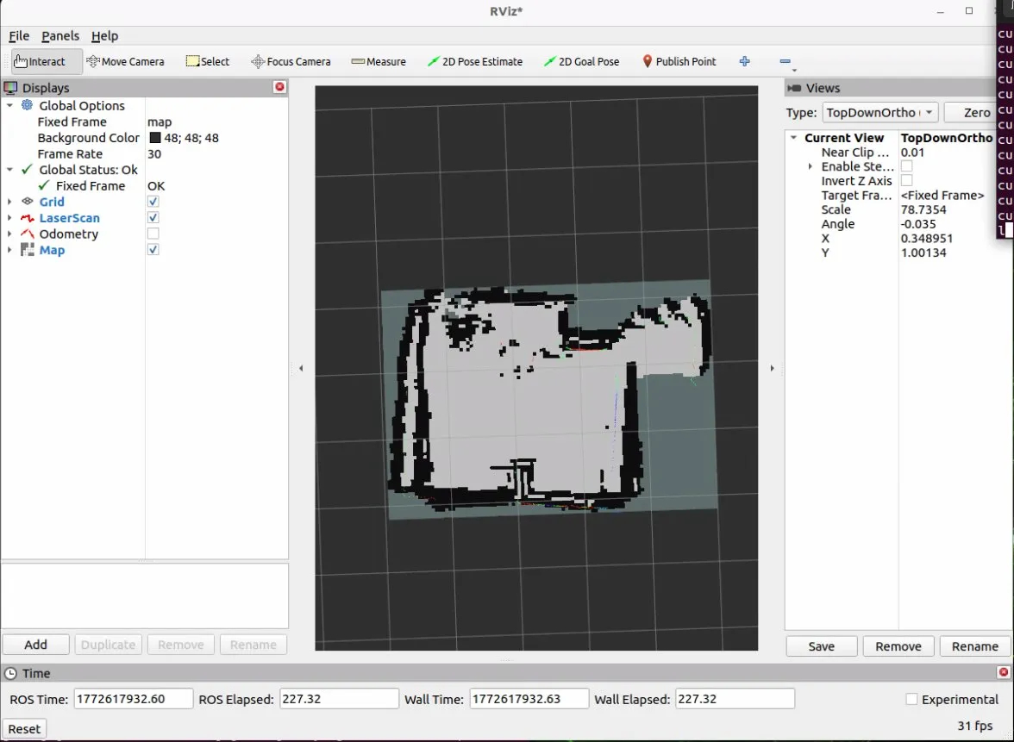
[picture p14: images/testing/session-009/session-009-First-Proper-SLAM-Map.jpg]
Session 009 — First Proper SLAM Map


**→ [Full session log](2026-03-04-session-009-hybrid-odometry-first-proper-slam-map.md)**

---

## Session 010 — 2026-03-09: Heading Hold, Velocity Ramp, ZUPT, PD Controller, and SLAM Tuning

**Goal:** Implement a software acceleration limiter to eliminate Jetson shutdown from
hard-acceleration current spikes, tune SLAM Toolbox parameters to reduce wall smearing,
and solve heading drift on soft surfaces that was degrading map quality over long sessions.

**Summary:** Confirmed the odometry projection math was already geometrically correct —
the drift problem was physical, not mathematical. Implemented a forward-only heading hold
PD controller (KP=1.6, KD=0.3) with gyro settle check, spike clamp, deadband, and a hard
output cap that keeps the rover tracking straight during SLAM runs. A software velocity
ramp (0.8 m/s² linear, 2.0 rad/s² angular) eliminated the Jetson shutdown caused by
hard-acceleration current spikes and improved motion smoothness as a side effect.
Zero Velocity Update (ZUPT) was implemented to continuously correct gyro bias drift at
every stationary pause throughout a session, addressing cumulative heading error that was
making longer sessions worse rather than better. Startup bias calibration was upgraded
from fixed-duration averaging to convergence-based standard deviation gating — switching
from peak-to-peak to std dev fixed a false-convergence-failure caused by single spike
outliers in an electrically noisy environment. SLAM Toolbox parameters were tuned for
full 10 Hz scan ingestion, larger loop closure search radius (15 m), and more tolerant
scan matching. Four mapping attempts across the session showed measurable improvement at
each step, with the final attempt producing the cleanest map to date — three tight walls
over two full perimeter laps.

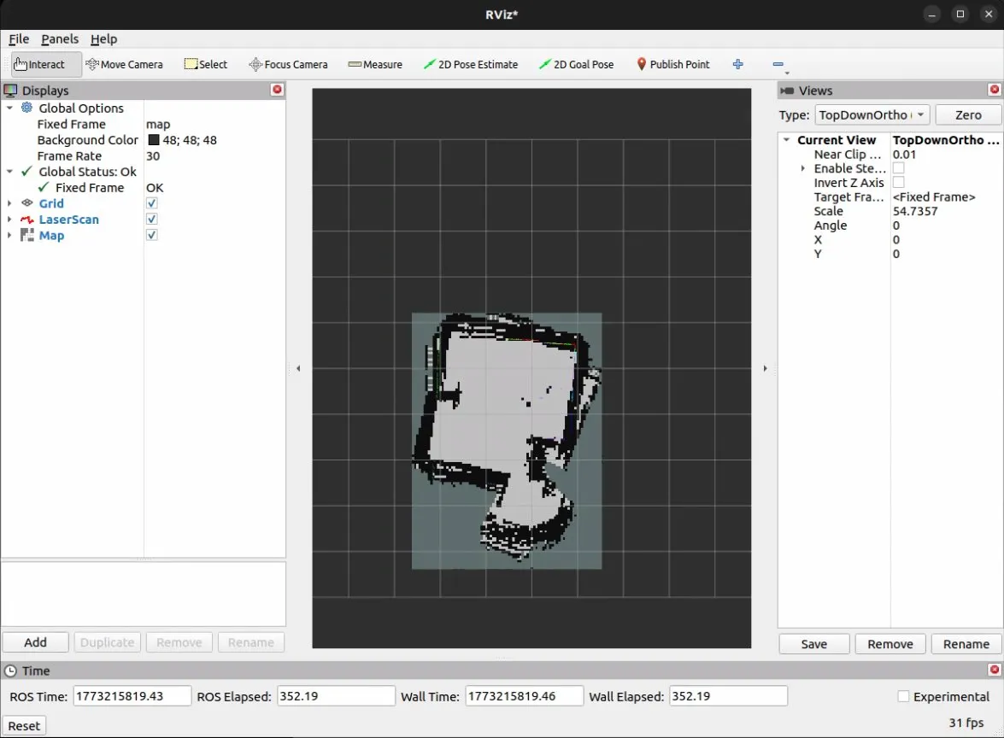
[picture p15: images/testing/session-010/session-010-map-attempt-4.png]
Session 010 — Best map result


**→ [Full session log](2026-03-09-session-010-heading-hold-velocity-ramp-zupt-slam-tuning.md)**

---

## Session 011 — 2026-03-13: Universal Heading Hold Tune for Mixed Surfaces
 
**Goal:** Validate the Session 010 heading hold PD controller on carpet and find a
single set of constants that works acceptably on both hard floors and soft surfaces,
without manual re-tuning between environments.
 
**Summary:** Testing the Session 010 heading hold constants on carpet exposed two
compounding failure modes: `HEADING_KP` had drifted to 2.2 (above the settled Session
010 value of 1.6, cause unknown), and `HEADING_DEADBAND` at 0.017 rad (~1°) was
narrower than the carpet vibration noise floor — causing the controller to generate
continuous phantom corrections on an already-correct heading. The goal was not a
carpet-specific tune but a universal baseline that tolerates soft surfaces without
breaking hard-floor performance. Two iterations were run with one battery charge and
no charger available: a first attempt at KD=0.4/DEADBAND=0.035 failed to fully
suppress surface jitter; a second at KD=0.5/DEADBAND=0.045 produced observably
improved straight-line tracking on carpet. Final universal constants: `HEADING_KP=1.4`,
`HEADING_KD=0.5`, `HEADING_DEADBAND=0.045 rad`, `GZ_MAX_RATE=2.0`. No SLAM map was
captured — battery constraints meant testing was rapid and observational. Result is
approximately 90% of the way toward the goal; a full validation mapping run across
both surfaces remains the next step.
 
**→ [Full session log](2026-03-13-session-011-universal-heading-hold-tune.md)**

---

## Session 012 — 2026-08-18: Switching to Lidar-Based Odometry

**Goal:** Return to the project after several months away, establish where the system
actually stands, and get past the map quality problem that has blocked Nav2 since
Session 010.

**Summary:** An initial mapping run with the Session 011 universal constants reproduced
the same failure as before the break — a rounded, lopsided map of a rectilinear room.
A direct check ruled out `GZ_SCALE` as the cause: two verified 90° turns reported
-91.87° and -89.86°, totalling -181.74° against a target of -180°, under 1% error. The
calibration was fine and the map was still wrong. Returning with fresh perspective led
to a different conclusion than previous sessions had reached: gyro-based odometry is not
a reliable foundation regardless of calibration quality, because the calibration itself
is conditional — Session 011 already showed constants tuned on hard floors do not
transfer to carpet, and gyroscope bias drifts with temperature, so a calibration valid
at boot is not necessarily valid later in a session. The lidar is the only sensor on the
rover unaffected by either surface or temperature, its main weakness being very large
spaces that fall outside its range — not a realistic condition for this robot. The
architecture was therefore changed to derive pose from the lidar using RF2O (Range
Flow-based 2D Odometry), which estimates planar motion from consecutive laser scans.
Two changes were required on the rover side: the driver's `odom → base_link` TF
broadcast was disabled so RF2O owns the transform outright (a TF edge can only have one
publisher), and the driver's wheel odometry topic was renamed to `/odom_wheel` to avoid
collision. RF2O then hung indefinitely on `Waiting for laser_scans....` with no error —
scans flowing at 10 Hz, subscription registered, QoS compatible, transforms resolving,
and no exception even at debug log level. The cause was its `init_pose_from_topic`
parameter defaulting to `/base_pose_ground_truth`, a simulation-only topic nothing on
this robot publishes; setting it empty starts the node at origin and resolved the hang.
The resulting mapping run produced the first genuinely useful map of the entire project:
single-cell-thick walls, sharp corners, and the room's 45° chamfer, wall protrusion, and
alcove all correctly placed. Saved as an 88 × 72 grid at 0.05 m/pixel.

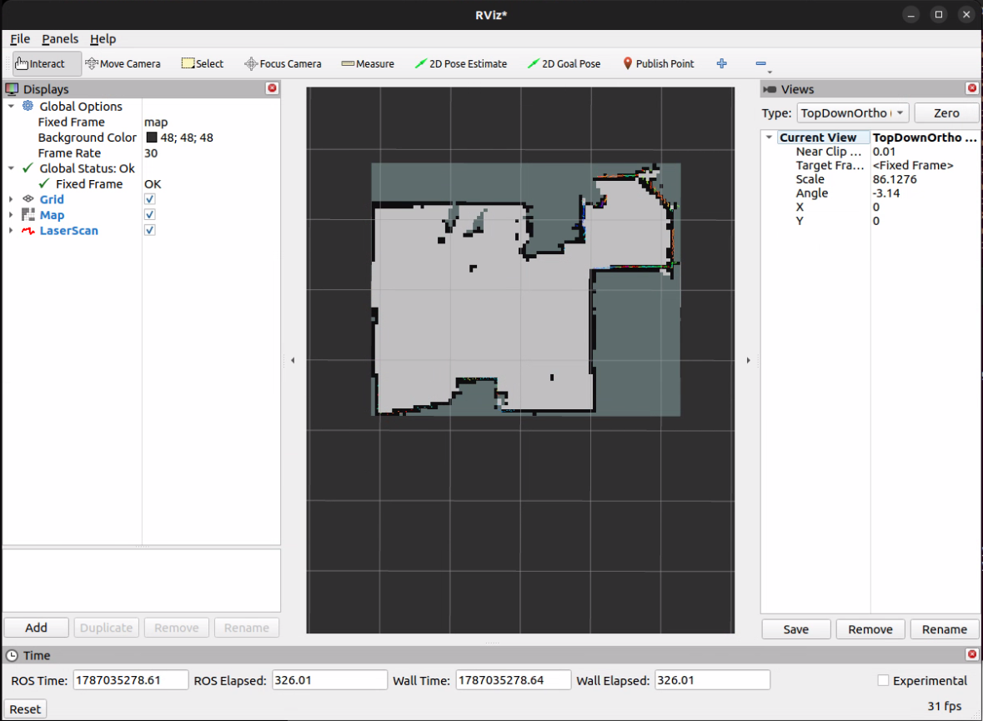
[picture p16: images/testing/session-012/session-012-First-Clean-Map.png]
Session 012 — First genuinely useful map, produced with RF2O lidar odometry


**→ [Full session log](2026-08-18-session-012-LIDAR-odometry-RF2O.md)**

---

## Session 013 — 2026-08-21: Nav2 Integration and First Autonomous Navigation

**Goal:** Bring Nav2 up on top of the RF2O + slam_toolbox stack from Session 012 and
reach a working `NavigateToPose` demo — the milestone the project has been aimed at
since Session 001.

**Summary:** Most of the session went to auditing numbers the stack had been running on
unverified. A sluggish-feeling map traced not to compute load but to `map_update_interval`
being absent from `slam_toolbox_params.yaml` entirely, leaving slam_toolbox on its
10-second default; a full `ros2 param dump` comparison then found `distance_penalty` and
`angle_penalty` were not real parameter names — the correct keys are
`distance_variance_penalty` and `angle_variance_penalty`, so the Session 010 tuning of
those values never took effect. ROS2 accepts unknown YAML keys silently, which is how
five separate config values in this project turned out to be doing nothing. Writing a
LiDAR wall-ranging script to measure motor constants then exposed a deeper problem: with
a wall tape-measured at 3.00 m directly ahead, the only coherent 3 m surface in `/scan`
was a 38° arc spanning ±180°. The RPLidar C1 is mounted with its housing arrow pointing
forward as documented, but its zero-bearing beam emits at the opposite end of the sweep —
something confirmed by a second flat surface 0.113 m behind the rover whose slant-range
profile matched a `1/cos(θ)` curve to within 5 mm out to 55°. `rover.urdf` had declared
`rpy="0 0 0"` on the `base_to_laser` joint since the project's first URDF; SLAM and RF2O
were never affected because every consumer was consistently wrong together, but Nav2
would have driven the rover backward along its planned path. Corrected to
`rpy="0 0 3.14159265"`. The motor mix was found to have no unit conversion at all —
`linear` in m/s written straight through as a normalised duty value, with a hardcoded
`0.5` angular coefficient implying a 1.0 m track width. Both constants were measured:
`MAX_WHEEL_SPEED = 0.956 m/s` by LiDAR wall ranging, and `TRACK_WIDTH = 0.174 m` by
caliper, replacing the 0.08 m slip-fitted value from `calibrate_track_width.py` — correct
for the inverse heading-from-encoders path it was written for, wrong by 2.2× for the
forward motor-mix path. Measured acceleration (0.648 m/s²) and deceleration (−0.699 m/s²)
both came in below the commanded 0.8 ramp rate, so Nav2's limits use hardware values
rather than software ones. Nav2 was configured with Regulated Pure Pursuit against a
live slam_toolbox map, and drove autonomously to a fixed goal pose from four different
starting positions, routing through narrow gaps without clipping — direct evidence the
measured footprint and inflation settings are correct. A fifth run launched from the
doorway into unmapped space aborted: with slam_toolbox launched once and no relocalization
in RF2O, the rover had no prior geometry to localize against, which is the known
limitation of this architecture and what AMCL exists to solve.

**→ [Full session log](2026-08-21-session-013-Nav2-Integration-and-First-Autonomous-Navigation.md)**

---

## Session 014 — 2026-09-24: Stack Audit, RF2O Startup Race, and the Wheel-Speed Floor

**Goal:** Make in-place rotation work under Nav2, the motion frontier exploration is
built from, after Session 013 left the rover stalling whenever the planner asked it to
turn on the spot.

**Summary:** Before changing the rotation behaviour I audited the Jetson against the
Session 013 record, and it did not hold up: the GitHub repository still held
pre-Session 013 code and could not build from a fresh clone, the `/battery_voltage`
publisher had never been deployed, and slam_toolbox was still running on the dead
`distance_penalty` and `angle_penalty` keys. I removed the dead keys, since every good
map had been built on the defaults, and rebuilt the battery publisher from the T:1001
`v` field (volts × 100), with warnings at 10.5 V and 9.6 V. Testing that publisher
exposed an RF2O startup race: the node looks up the `base_link → laser` transform once,
on its first scan, and if `/tf_static` has not arrived yet it logs an error and falls
back to identity for the rest of the run. Harmless until Session 013's 180° URDF fix, it
now silently negated translation in `/odom`, and it hit 6 of 8 launches in one day. A
one-line patch makes RF2O retry until the transform exists; a forced-race test with
`robot_state_publisher` withheld proved it, and the fix lives on my fork, pinned in
`rover.repos`. For rotation itself, a wheels-in-air test showed the Waveshare board
already runs closed-loop wheel speed control in m/s, which exposed a 4.6% unit error in
my motor mix, and an in-place rotation test on three surfaces showed the controller
cannot regulate wheel speeds below about 0.08 m/s. Nav2's default 0.6 rad/s rotation
asked each wheel for 0.052 m/s, which was the entire stall. The mix now sends m/s with a
0.10 m/s floor applied to both wheels together, preserving turn curvature, and the rover
rotates reliably under teleop and Nav2 on every surface tested. The same test measured
skid-steer scrub at 0.43 on all three surfaces, an effective track of about 0.405 m,
left for a separate experiment. Finally, `~/ros2_ws` became a git clone of the
repository with third-party packages pinned in `rover.repos`, and a fresh clone now
builds and runs the full stack.

**→ [Full session log](2026-09-24-session-014-Stack-Audit-RF2O-Startup-Race-and-the-Wheel-Speed-Floor.md)**

---

## Session 015 — 2026-09-25: Handheld Control Unit on the ROG Ally Without a Router

**Goal:** Operate the rover from a handheld ASUS ROG Ally anywhere in the house, with the
live map, Nav2 goals, stick driving, stack control, map saving and a safe shutdown, and
with no laptop, no NoMachine session, and no dependence on the home router.

**Summary:** I dropped the planned custom Windows app before building it, because
Foxglove already draws maps, scans, costmaps and paths and publishes goals; the Ally runs
Foxglove desktop and the Jetson runs `foxglove_bridge` on port 8765, so all the custom
work is on the robot. Nav2 publishes velocity from both the smoother and the behavior
server, so instead of touching Nav2 I put `twist_mux` on the driver's input: `/cmd_vel`
at priority 10, the pendant stick on `/cmd_vel_joy` at 100 behind the LB deadman
(0.25 m/s, 1.5 rad/s), and teleop-mode and e-stop locks at 50 and 255. Four systemd user
services run the bridge, a new `pendant_control` node, bringup and Nav2; because the MFD
board keeps executing its last command, every bringup stop sends the zero command twice,
50 ms apart. The node toggles each service, saves maps by name, and powers off after two
presses within 5 s. For router-free use the Jetson hosts `NullIsland-Rover` at
`10.42.0.1`, which works on 2.4 GHz but fails on 5 GHz with the card's regulatory country
unset. Switching networks then split the ROS graph, since nodes advertise the addresses
they started with; every node runs on the Jetson, so `ROS_LOCALHOST_ONLY=1` fixed it.
At boot NetworkManager joins home Wi-Fi when it is in range and starts the hotspot
otherwise (right on 6 of 6 reboots), and a root watchdog starts the hotspot after 60 s
without Wi-Fi and tries home only after 5 minutes with no client connected, taking no
action on any reading that fails or hangs.
Still open: the watchdog's running cycle is untested on the rover, the hotspot drops for
up to about 70 s every 5 minutes when nobody is connected, the locks have no pendant
buttons and fail open, and the Foxglove layout is not in the repository.

The handheld control unit driving the rover while Nav2 navigates the house (https://www.youtube.com/watch?v=RMOsRye9tLc)

*[Watch on YouTube](https://www.youtube.com/watch?v=RMOsRye9tLc): the handheld control unit driving the rover while Nav2 navigates the house.*

**→ [Full session log](2026-09-25-session-015-Handheld-Control-Unit-on-the-ROG-Ally-Without-a-Router.md)**

---

## Session 016 — 2026-10-06: Autonomous Mapping With My Own Frontier Explorer

**Goal:** Have the rover explore the house on its own, build the map as it goes, save it
when it is complete, and drive back to where it started, with one start command and
nobody steering.

**Summary:** I built exploration on top of the Session 015 stack around `explore_lite`:
an exploration package, an autosave node that checkpoints the map, saves the final map
and logs every run, and a `rover-explore` service. Getting there took a tf2 upgrade to
0.25.24 from ros2-testing to fix a deadlock that froze Nav2, a reboot to clear stale
Fast DDS shared memory left by the crashes, and moving the return home into the autosave
node, because explore_lite's own cancel-all could cancel its return goal. On Oct 7
explore_lite mapped the whole house in 591 s, but it completed none of its 57 goals and
abandoned 51 halfway. Its source explained why: straight-line frontier costs, no
commitment to a goal, centroid goals that can be unreachable, and permanent blacklisting
on Humble. Before changing anything I wrote an offline simulator that runs exploration
policies from the same start poses on real maps of the house. It showed that tuning
explore_lite's parameters does not fix it, that my own first idea, a forward sector rule,
made one start drive 61% more, and that driving distance, reachability for the robot's
footprint, commitment and a route through all frontiers cut the distance by about a
quarter. So I wrote my own explorer, `rover_explorer`, with every decision in one module
without ROS that the simulator runs unchanged; porting it exposed a failure at gaps the
lidar sees through, which I fixed before it reached the robot. In simulation it drives
19% and 28% less than explore_lite on the two maps. On the robot it explored the house
in 453 s, finished one area before moving to the next, ended with no reachable frontier
left, and drove home. The first final save failed during the drive home, so the autosave
node now drives home first and saves the final map with the rover at rest.

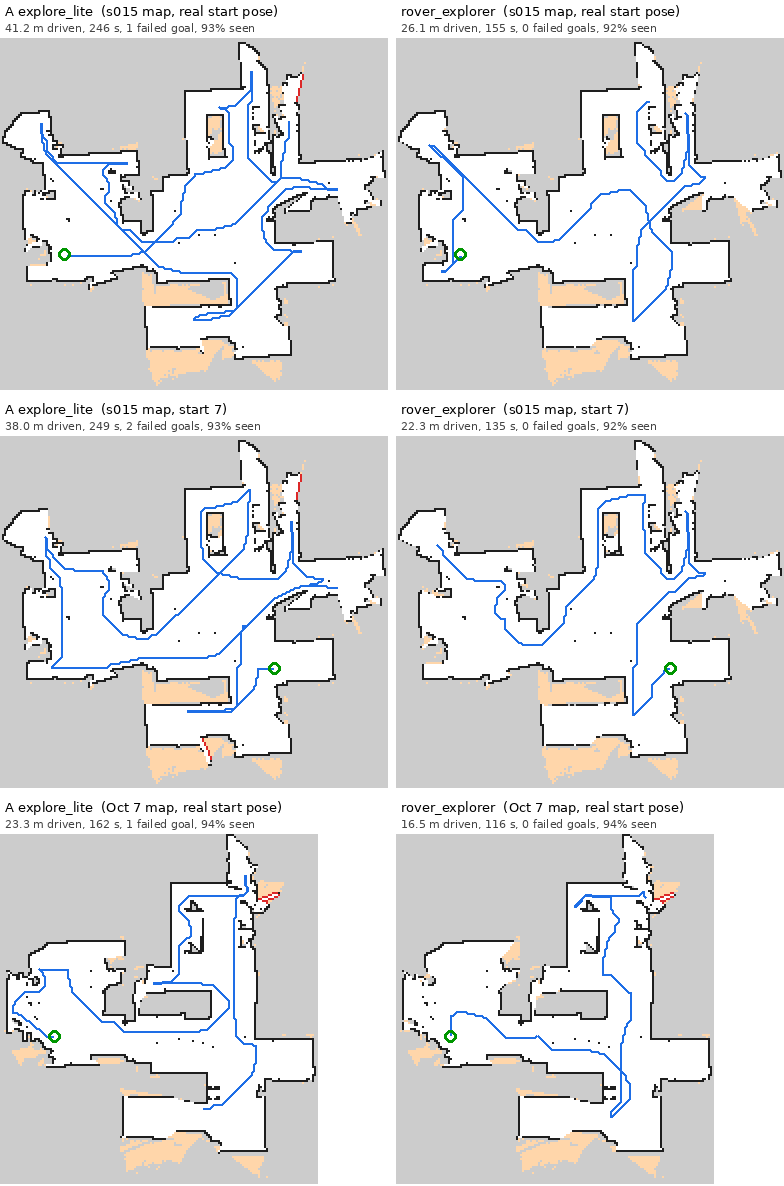
[picture p17: images/testing/session-016/session-016-sim-explore-lite-vs-rover-explorer.png]
Simulated explore_lite and rover_explorer from the same start poses


*Simulated explore_lite (left) and rover_explorer (right) from the same start poses, on
the Session 015 map and the Oct 7 map.*

**→ [Full session log](2026-10-06-session-016-Autonomous-Mapping-With-My-Own-Frontier-Explorer.md)**

---

## Session 017 — 2026-10-13: How Each Node Works, and the Conclusion of Project #1

**Goal:** Explain how every node I wrote works, with one flowchart each and the reasons
behind it, and close Project #1 with a conclusion.

**Summary:** I documented the whole stack: a diagram of how the nodes connect, one
Mermaid flowchart for each node I wrote, and a plain-language account of each one with
the sessions that decided it. `rover_driver` turns velocity commands into wheel speeds in
m/s, ramped at 0.8 m/s² and 2.0 rad/s², lifted as a pair to a 0.10 m/s floor and clamped
at 0.956 m/s. Reading it closely showed that it acts only when it processes a feedback
packet from the board, about 12 Hz rather than its 20 Hz timer, so its 0.5 s command
watchdog depends on that feedback, which the READMEs now say. The RF2O chart sets my
one-line startup fix against the Adlink-ROS port; `pendant_control` runs the services,
map saves and the two-press shutdown; `rover_explorer` and its planner choose frontiers
by driving distance, reachability for the robot's footprint, a viewpoint that sees the
frontier, a route through the 20 cheapest and commitment to the current target; and
`explore_autosave` checkpoints the map, drives home and then saves the final map at rest.
The network watchdog takes no action on a reading it cannot make. Gyrodometry with ZUPT
and the heading hold, which no longer drive the robot, have their own section, with
tables of how the odometry and the motor mix changed. I also corrected code comments
that described earlier versions of the driver, the Nav2 parameters and the planner, and
pointed the RF2O build notes at my fork. After 17 sessions and three odometry designs,
one command makes the rover explore the house, in 453 s on its first run, drive home and
save the map. It still navigates only on the map it builds live, and one battery feeds
both the computer and the motors.

**→ [Full session log](2026-10-13-session-017-How-Each-Node-Works-and-the-Conclusion-of-Project-1.md)**

---
