ArshamFN/WaveShare-Jetson-ROS2-Rover/images/testing/session-006-migration/session-006-UGV02-rear.jpg

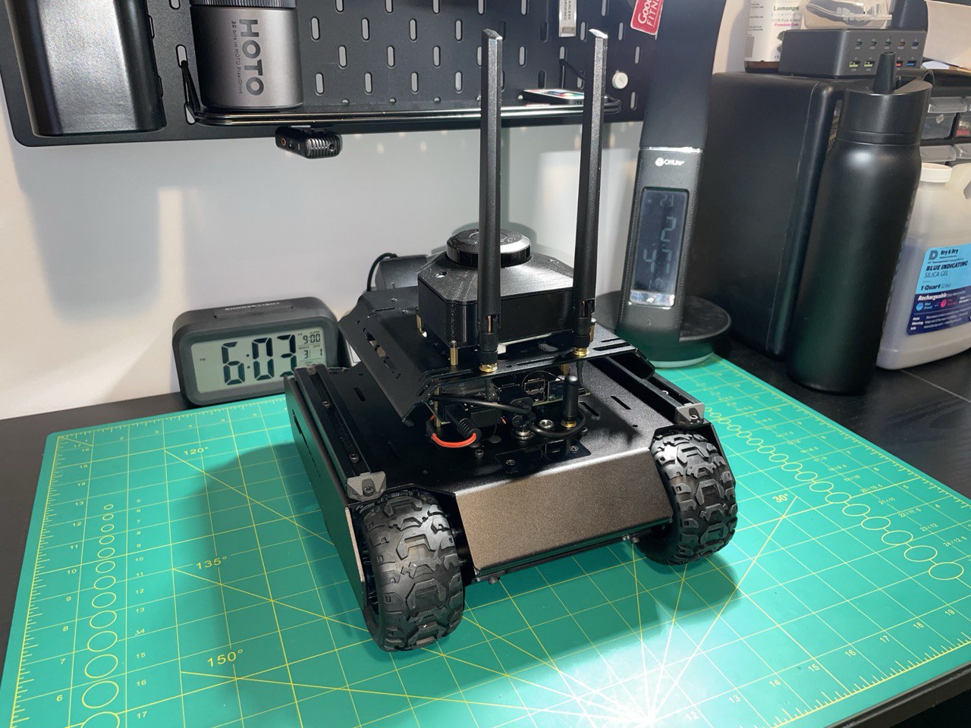
images/testing/session-006-migration/session-006-UGV02-rear.jpg
