ArshamFN/WaveShare-Jetson-ROS2-Rover/(commit log)

2026-02-21 Uploaded The Rover Dimension Schematics
2026-02-21 scripts: add UART sanity check diagnostic tool for rover serial connection
2026-02-21 scripts: add UART interactive terminal for sending JSON commands to rover
2026-02-22 docs: add session 002 log - UART issue fixed and root cause analysis
2026-02-22 Updated UART-Simple-Sanity-Check.py after UART issue resolution
    [UART-Simple-Sanity-Check.py]
2026-02-22 Update Serial_Simple_Control.py after UART issue resolution
    [Serial_Simple_Control.py]
2026-02-22 cad: add rover top face reference model (f3d, step, png)
    [WaveShare-Wave-Rover-Top-Face-Reference.f3d, WaveShare-Wave-Rover-Top-Face-Reference.step]
2026-02-22 docs: update BOM — mark items received, add additional hardware purchases
2026-02-22 docs: add grd-cover README — v1 in progress
2026-02-24 docs: add session 003 log — CAD design for GRD cover and RPLidar mount
2026-02-25 src/ROS2: created rover-driver README.md
2026-02-25 src/ROS2/rover-driver: Create rover-driver-node.py
2026-02-25 src/ROS2/rover-driver: Create setup.py
2026-02-25 src/ROS2/rover-driver: Create package.xml
2026-02-25 docs: add session 004 log - power architecture, LiDAR integration, ROS2 motor control
2026-02-27 cad/grd-cover-jetson-mount : Updated README.md added v2
2026-02-27 cad/Rover-Top-Cover: Created directory for v1
2026-02-27 Rover-Top-Cover-v1.stl Uploaded
    [Rover-Top-Cover-v1.stl]
2026-02-27 cad/Rover-Top-Cover: Created directory for v2
2026-02-28 images/build/final-assembly: uploaded-session-004-photos
2026-02-28 feat: add rover URDF with base_link to laser transform
    [rover.urdf]
2026-03-02 docs: session 006 — hardware assessment and platform migration to UGV02
    Wave Rover encoder limitation discovered. Three remediation options were evaluated.
    UGV02 selected: JGB37-520 encoder motors, MFD board with ROS continuous
    feedback mode, 4kg payload rating. Hardware migration complete.
2026-03-02 Uploaded: session-003-lidar-mounting-case
2026-03-02 Updated session-006 motor photo
2026-03-02 docs: add session 006 — hardware assessment and platform migration
    Wave Rover encoder limitation discovered via GRD firmware docs.
    N20 motors have no hall-effect sensors; encoder commands are UGV01-only.
    Chassis also chronically underpowered under Jetson payload.
    Three options evaluated: open-loop odometry (rejected), encoder motor
    swap (rejected — encoders on underpowered chassis produce unreliable
    ground truth), full platform replacement (selected).
    UGV02 selected: DCGM-370-12V-EN-333RPM encoder motors confirmed by
    EN part number designation and visible hall-effect sensor connector.
    MFD board with 4 encoder ports and ugv_base_ros firmware. 4kg payload.
    Hardware migration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
2026-03-04 docs: add session 007 log — odometry calibration and TRACK_WIDTH investigation
2026-03-04 docs: update test-logs index — add session 007 entry
2026-03-04 docs: add session 008 log — calibration script, encoder swap, battery sag discovery
2026-03-04 scripts: add calibrate_track_width.py
    3-phase gyro-referenced TRACK_WIDTH calibration
2026-03-07 docs: add session 009 log — hybrid odometry and first proper SLAM map
2026-08-18 docs: add session-012-lidar-based-odometry-with-RF2O
2026-08-18 Create README.md for RF2O-laser-odometry
2026-09-25 Restructure repository as a colcon workspace
    Move packages to src/<package_name>, scripts to scripts/, and third-party setup notes to docs/software/. Moves only; file contents are unchanged.
    [rover.urdf]
2026-09-25 Sync packages with the code deployed on the rover
    Bring rover_driver and robot_description in line with the code running on the robot: the wheel-speed mix with its low-speed floor, the battery voltage topic, the Nav2 bringup launch file, the RF2O and Nav2 parameters, and the URDF laser yaw fix. Adds the ament_python package files missing from the previous layout.
    [rover.urdf]
2026-09-25 Add workspace tooling, maps, scripts, and launchers
    Add rover.repos pinning the patched rf2o fork and rplidar_ros, replace the ROS1 .gitignore with a root-anchored ROS2 one, and add the saved maps, calibration and test scripts, and desktop launchers. Update links to moved files.
    [drive_pulse.py, measure_max_speed.py, scan_dump.py, t1_loop_test.py, t1_rotate_test.py]
2026-09-25 docs(session-014): wheel-speed floor and RF2O startup race, session log, and index entry
    Add the Session 014 log and its index entry. Update the README and the rover_driver README for the m/s motor interface and wheel-speed floor, battery monitoring, the RF2O startup fix, Nav2, and building from a fresh clone.
2026-09-25 feat(session-015): twist_mux velocity chain with joystick teleop and pendant locks
2026-10-14 feat(session-016): autonomous exploration with a custom frontier explorer, map autosave, and return to start
    Add the rover_explore package: the rover_explorer node and its frontier_planner module, which has no ROS dependencies, the explore_autosave node, which saves map checkpoints, drives back to the start pose and then saves the final map, and explore.launch.py, which keeps explore_lite as a baseline. Pin m-explore-ros2 in rover.repos and add the rover-explore user service.
2026-10-14 docs(code): correct stale comments in rover_driver, nav2_params and frontier_planner
    Comment and docstring changes only; no code changes.
    - rover_driver_node.py: describe the node as it has run since Session 014
    (wheel speed targets in m/s, MAX_WHEEL_SPEED only a clamp), document the
    low-speed floor constants, the feedback-driven timing (about 12 Hz) and
    the command watchdog's dependence on it, correct the ZUPT threshold
    (5 mm, not 0.5 mm) and settle time (about 1.7 s), and credit gyro
    heading to Session 009.
    - nav2_params.yaml: the velocity smoother comment no longer claims a 20 Hz
    driver loop.
    - frontier_planner.py: describe the four viewpoint tiers.
2026-10-14 docs(session-017): how each node works and the conclusion of Project #1, session log, and index entry
    Session 017 log: a system diagram, one flowchart per node, plain-language
    explanations with the sessions behind each design, the algorithms no
    longer active on the robot, and the conclusion of Project #1. Test-log
    index row and entry.
    README: status complete; the command watchdog sentences now say the check
    runs on each feedback packet from the MFD board. rover_driver README: the
    same for the watchdog, and ZUPT's settle time. RF2O notes: credit and
    build now point at the fork pinned in rover.repos.
